adamjvr/CavroRibbonInterfaceBoard/PCB/ProjectOutputs/Import Error Report - Cavro Ribbon Interface Top.html

Altium customize

# DXF/DWG File Import Error Report

Date | : | 12/30/2013
Time | : | 5:23:01 PM
Elapsed Time | : | 00:00:28
PCB Filename | : | C:\Users\Adam\Documents\GitHub\CavroRibbonInterfaceBoard\PCB\Cavro Ribbon Interface Top.PcbDoc
DXF Filename | : | C:\Users\Adam\Documents\GitHub\CavroRibbonInterfaceBoard\PCB\CavroTopBoard.DXF

MTEXT entity was discarded because of invalid insertion point (0.3159473936,0.2346886587)
MTEXT entity was discarded because of invalid insertion point (0.3159473936,-0.0507613413)
