adamjvr/CavroRibbonInterfaceBoard/Fabrication/Cavro Ribbon Interface BOM.xlsx

Symbol | Value | Package | Quantity | Digikey Part Number | Manufacturer Part Number | Price | Comment
R5, R6 | 220r | J1-0603 | 2 | RHM220CFCT-ND | MCR03ERTF2200 | 0.1
C13, C16, C17, C18, C19, C20, C21, C22, C27, C28, C29 | 100nF | 1608[0603] | 11 | 399-1096-1-ND | C0603C104K4RACTU | 0.1
R4 | 68k | SM 0805 - gap trimmed | 1 | RHM68KARCT-ND | MCR10EZPJ683 | 0.1
C14, C15 | 47uF | Panasonic VS C | 2 | PCE3890CT-ND | EEE-1CA470WR | 0.43 | only 1 in stock at digikey
R3 | 28K | SM 0805 - gap trimmed | 1 | RMCF0805FT28K0CT-ND | RMCF0805FT28K0 | 0.04
C2, C3, C6, C8, C10, C11 | 10uF | C1206 | 6 | 399-8269-1-ND | T491A106K016AT | 0.41
C4, C7, C12 | 1uF | C1206 | 3 | 399-3678-1-ND | T491A105K016AT | 0.34
R1, R2 | 1K | SM 0805 - gap trimmed | 2 | RMCF0805JT1K00CT-ND | RMCF0805JT1K00 | 0.03
FB3, FB4 |  | SM 0805 - gap trimmed | 2 | 240-2391-1-ND | MI0805L301R-10 | 0.1 | 2A Rated Ferrite Bead 0805
RIBBON | HDR1X16H | 2.54mm pin pitch | 1 | 609-3317-ND | 68016-116HLF | 0.66
T1, T2, T3, T4 | HDR1X2 | 2.54mm pin pitch | 4 | A1921-ND | 640456-2 | 0.14
END_STOP1, END_STOP2 | HDR2X3 | 2.54mm pin pitch | 2 | 3M9459-ND | 961206-6404-AR | 0.42
MOTOR | HDR2X5 | 2.54mm pin pitch | 1 | 609-4710-ND | 68692-210HLF | 0.45
D1, D3 | LED | SM 0805 polarized | 2 | 754-1437-1-ND | APT2012QBC/D | 0.51
U2 | LM7805 | DPAK-3 | 1 | MC7805CDTGOS-ND | MC7805CDTGOS-ND | 0.62 | 5v LDO fixed output 800mA
U4, U5, U6, U7 | MAX31855EASA+ | MAXM-S8+4_N | 4 | MAX31855EASA+-ND | MAX31855EASA+ | 4.57 | Thermo couple ADC
D2 | PMEG4050EP | PMEG4050EP | 1 | 568-7408-1-ND | PMEG4050EP,115 | 0.52 | Shottky Diode
U1 | TLV117112 | TLV117112 | 1 | 296-28778-1-ND | TLV1117LV33DCYR | 0.68 | 3.3 fixed output LDO
U3 | TPS73101 | TPS73101 | 1 | 296-27058-1-ND | 296-27058-1-ND | 1.07 | Ti TPS73101 Adjustable LDO
U9 | TXB0108 | TXB0108 | 1 | 296-21527-1-ND | TXB0108PWR | 2.3 | Ti Bidirectional level translator
 |  |  |  |  | Total Cost | 32.59
