adamjvr/CavroRibbonInterfaceBoard/PCB/CavroTopBoard.DXF

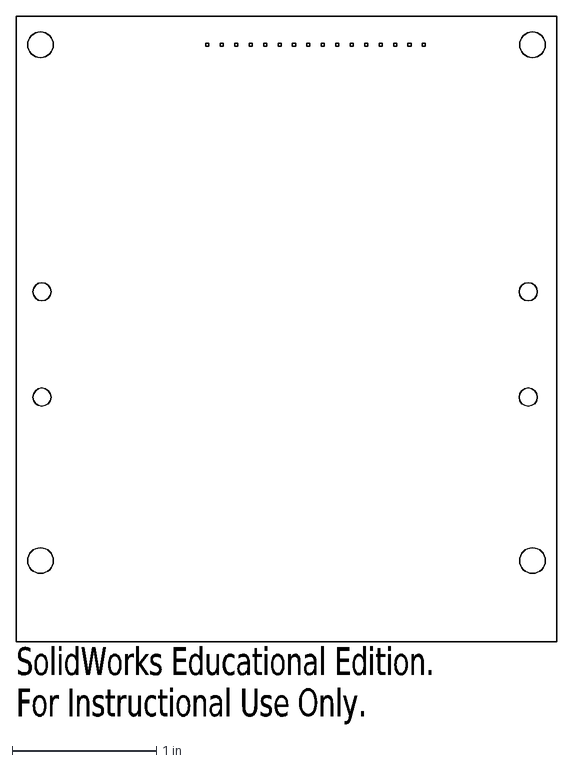
[picture p2: CAD file, 2013-12-30]
PCB/CavroTopBoard.DXF
SolidWorks Educational Edition.
For Instructional Use Only.
