adamjvr/CavroRibbonInterfaceBoard/PCB/cavrotop.dxf

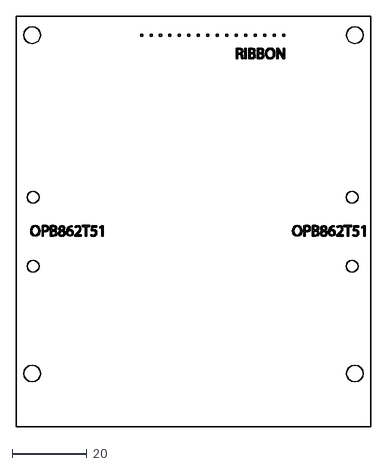
[picture p3: CAD file, 2013-12-30]
PCB/cavrotop.dxf
95.0 x 110.0
