adamjvr/CavroRibbonInterfaceBoard/(list of files, cad)

Other CAD files:
PCB/cavrotopFix2.dxf
PCB/cavrotopFix.dxf
