adamjvr/CavroRibbonInterfaceBoard/PCB/Cavro Ribbon Interface.pdf

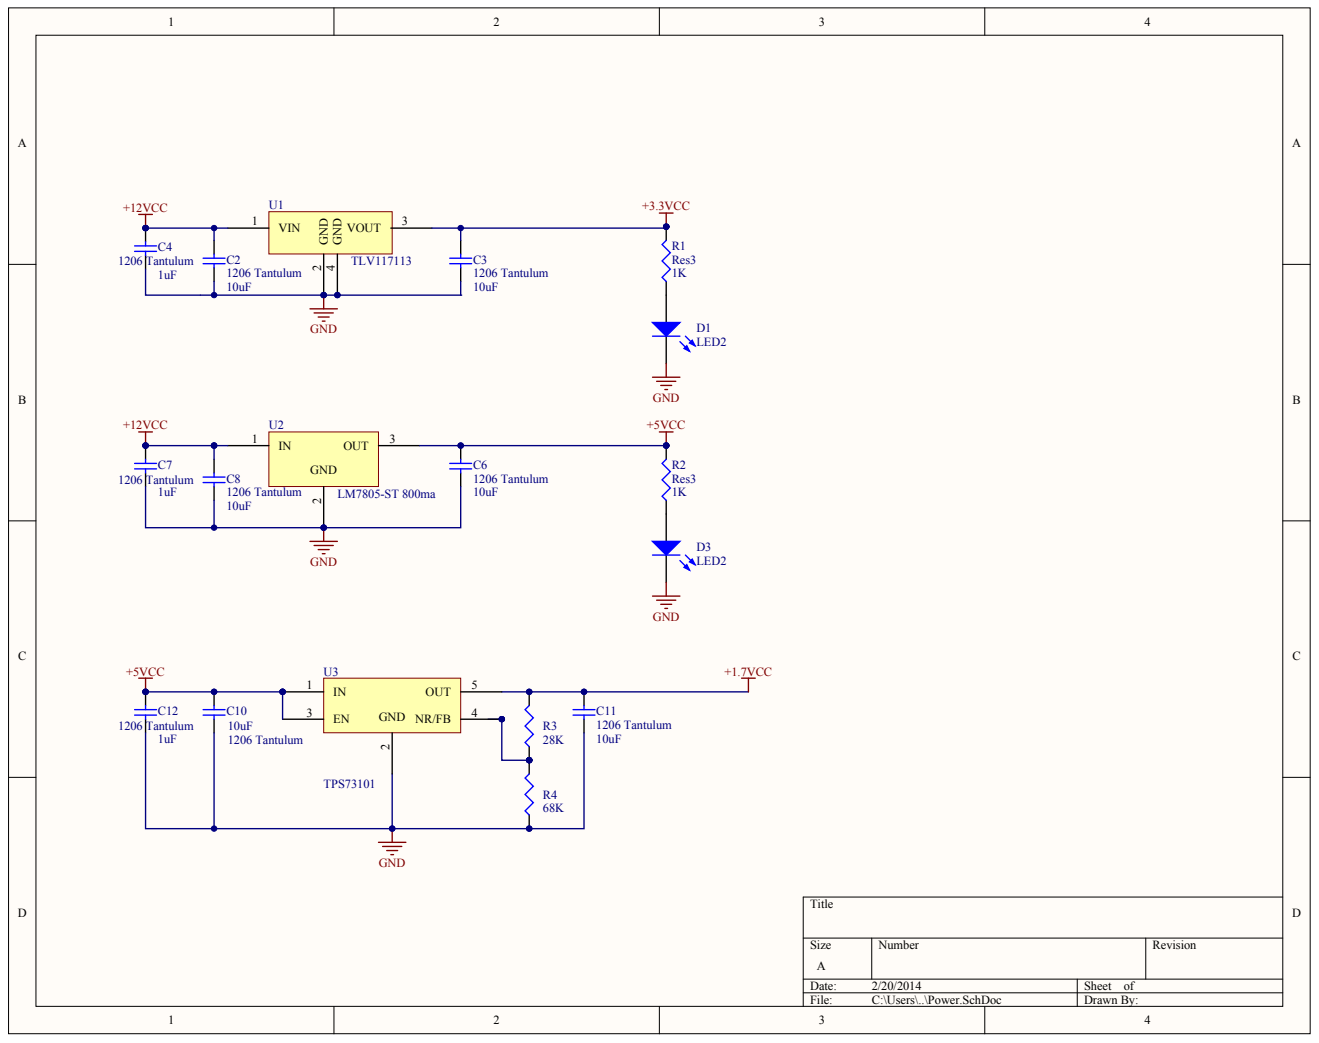
[picture p7: page 1]

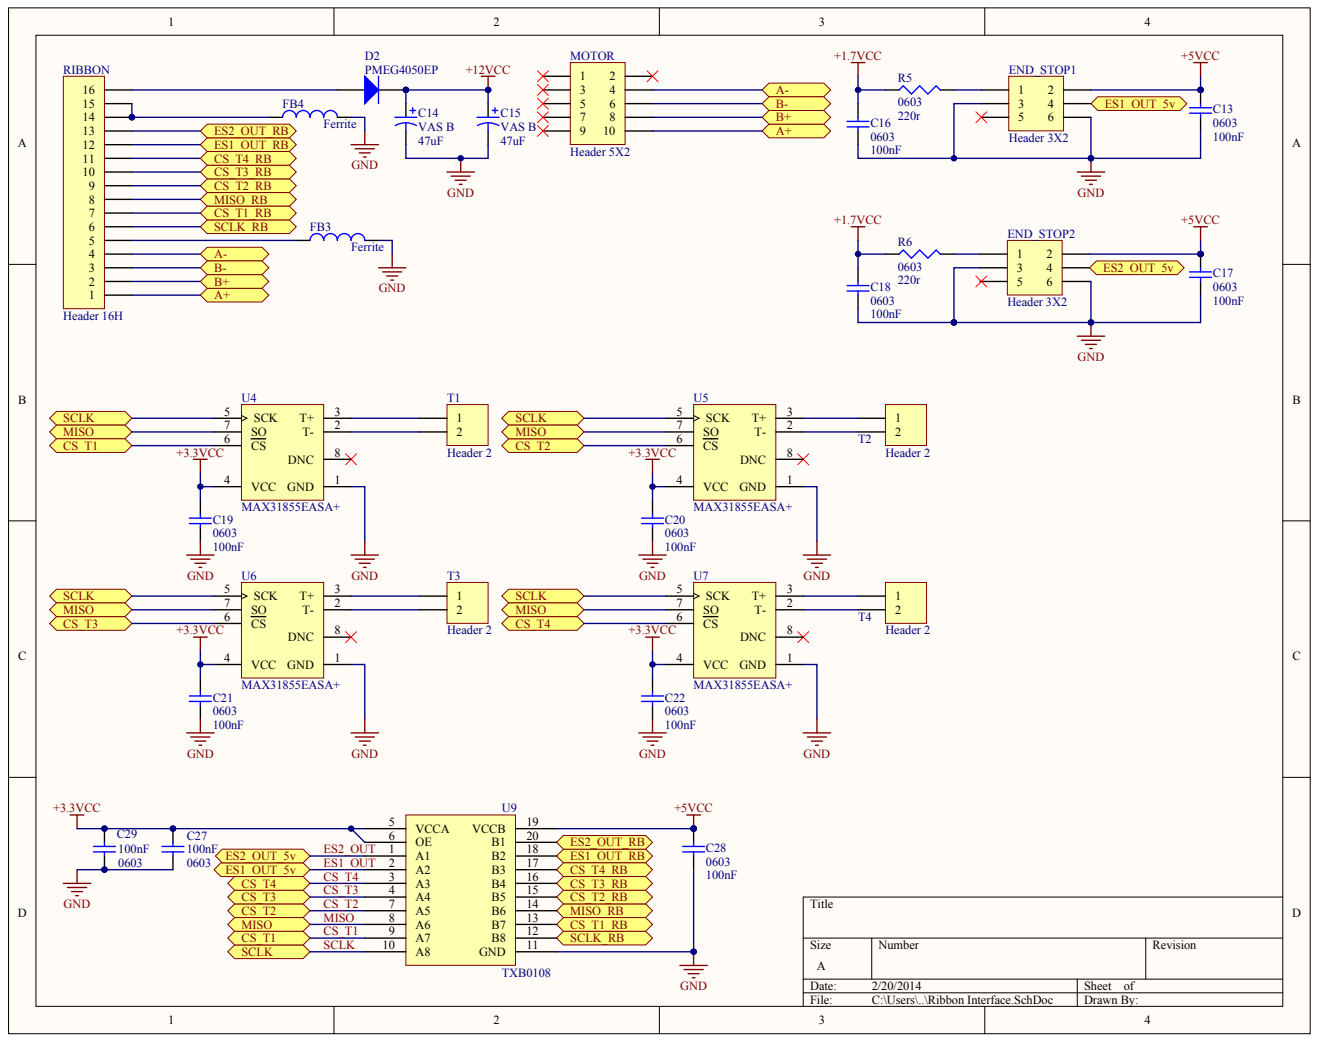
[picture p8: page 2]

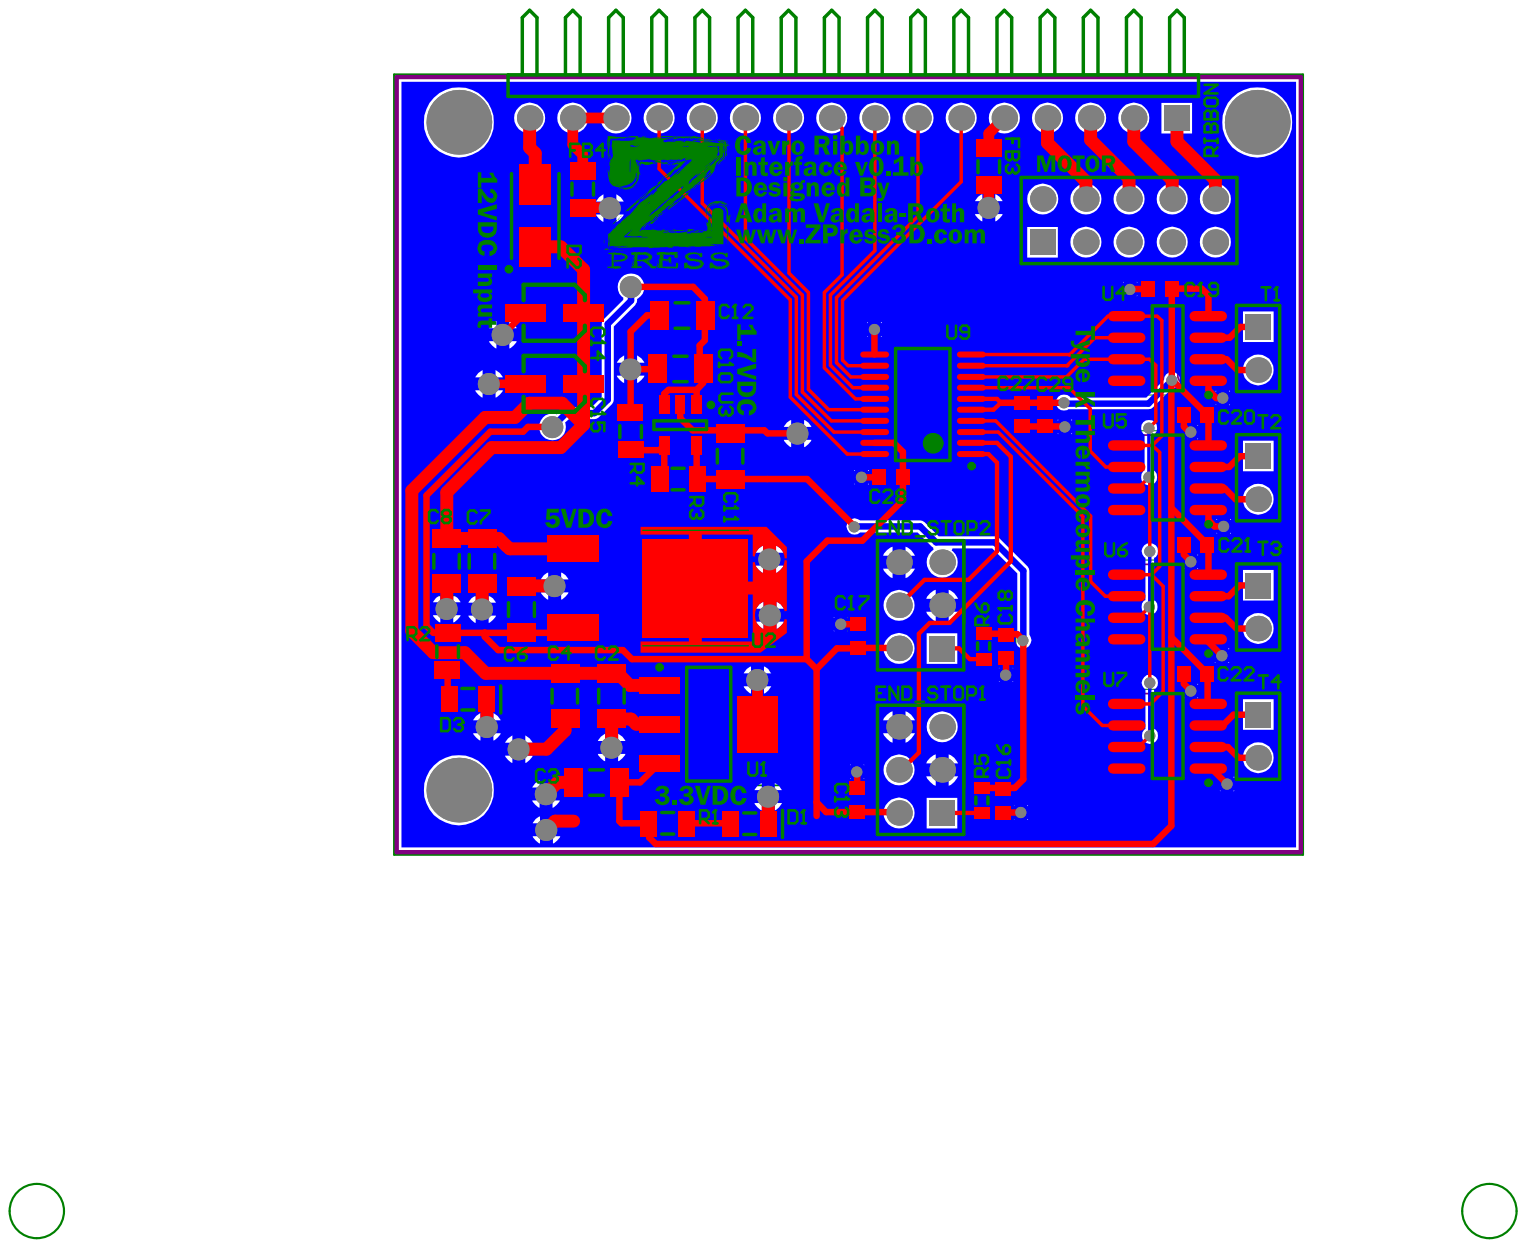
[picture p9: page 3]
