adamjvr/CavroRibbonInterfaceBoard/(list of files, drawings)

Other design files:
PCB/Adams Altium Library.PcbLib
PCB/Adams Altium Library.SchLib
PCB/Cavro Ribbon Interface Top.PcbDoc
PCB/Cavro Ribbon Interface.PrjPcb
PCB/Power.SchDoc
PCB/Ribbon Interface Footprints.PcbLib
PCB/Ribbon Interface Schem Symbols.SchLib
PCB/Ribbon Interface.SchDoc
PCB/Thermocouple Channel.SchDoc
