adamjvr/CavroRibbonInterfaceBoard/(commit log)

2013-12-21 Initial Commit
    Basic schematic for Cavro conversion RepStrap interface board. Power
    regulation and level conversion will be added in the next commit.
    [Adams Altium Library.PcbLib, Adams Altium Library.SchLib, Cavro Ribbon Interface.PrjPcb, Power.SchDoc, Ribbon Interface Footprints.PcbLib, Ribbon Interface Schem Symbols.SchLib, Ribbon Interface.SchDoc]
2013-12-21 Power
    3.3v reg schematic at to the power system
    [Power.SchDoc, Ribbon Interface.SchDoc]
2013-12-23 Schematic complete
    Schematic completed and PCB layout started.
    [Adams Altium Library.PcbLib, Adams Altium Library.SchLib, Cavro Ribbon Interface Top.PcbDoc, Cavro Ribbon Interface.PrjPcb, Power.SchDoc, Ribbon Interface Footprints.PcbLib, Ribbon Interface Schem Symbols.SchLib, Ribbon Interface.SchDoc]
2013-12-23 Schematic complete
    schematic complete and smart PDF added.
    [Ribbon Interface.SchDoc]
2013-12-30 Layout Started
    Layout has been started.
    [Cavro Ribbon Interface Top.PcbDoc, Cavro Ribbon Interface.PrjPcb, cavrotop.dxf, cavrotopFix.dxf, cavrotopFix2.dxf]
2013-12-30 DXF Fix
    New board outline DXF generated from Solidworks.
    [CavroTopBoard.DXF]
2013-12-31 DXF Added to PCB
    DXF board outline primitives added to PCBdoc
    [Cavro Ribbon Interface Top.PcbDoc]
2013-12-31 PCB Routing Progress
    90% complete with initial route.
    [Cavro Ribbon Interface Top.PcbDoc, Power.SchDoc, Ribbon Interface.SchDoc]
2013-12-31 PCB Finished
    PCB Layout complete
    [Cavro Ribbon Interface Top.PcbDoc, Power.SchDoc]
2014-01-10 Logo
    logo added to PCB
    [Cavro Ribbon Interface Top.PcbDoc, Power.SchDoc]
2014-01-15 graphics updated
    QR code enlarged and moved to back.
    [Cavro Ribbon Interface Top.PcbDoc]
2014-01-20 None
    none
    [Cavro Ribbon Interface Top.PcbDoc, Ribbon Interface.SchDoc]
2014-02-01 Footprints
    footprint errors fixed
    [Cavro Ribbon Interface Top.PcbDoc]
2014-02-09 Fabrication prep
    A keepout layer has been added and necessary fabrication files have been
    generated.
    [Cavro Ribbon Interface Top.GBL, Cavro Ribbon Interface Top.GBO, Cavro Ribbon Interface Top.GBP, Cavro Ribbon Interface Top.GBS, Cavro Ribbon Interface Top.GKO, Cavro Ribbon Interface Top.GM1, Cavro Ribbon Interface Top.GTL, Cavro Ribbon Interface Top.GTO]
2014-02-11 Cleanup
    Desing cleaned up, in the process of cleaning up for fabrication
    [Cavro Ribbon Interface Top.PcbDoc, Cavro Ribbon Interface.PrjPcb, Ribbon Interface.SchDoc]
2014-02-20 Fabrication Updates
    Many modifications to correct errors in the design were made. The level
    translation isses were resolved with a Ti TXB0108 octal level
    translator, the ribbon port is 5 volt tolerant. Power supply was
    significantly modified with the rearranging of filtering caps and
    removal of the Panasonic aluminum electrolytics.
    [Cavro Ribbon Interface BOM.xlsx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]
2014-02-21 Caps Retooled
    cap sizes retooled
    [Cavro Ribbon Interface Top.GBL, Cavro Ribbon Interface Top.GBO, Cavro Ribbon Interface Top.GBP, Cavro Ribbon Interface Top.GBS, Cavro Ribbon Interface Top.GKO, Cavro Ribbon Interface Top.GM1, Cavro Ribbon Interface Top.GTL, Cavro Ribbon Interface Top.GTO]
2014-02-22 Fabrication ready
    BOM and gerber files found in Fabrication directory
    [Cavro Ribbon Interface BOM.xlsx]
2014-03-01 Fab updates
    Fab updates
    [Cavro Ribbon Interface Top.PcbDoc]
